TechDenNL/GameConsole/Docs/Game-Console v3.31/5 - Game-Console panel v3.3 - solder.jpg

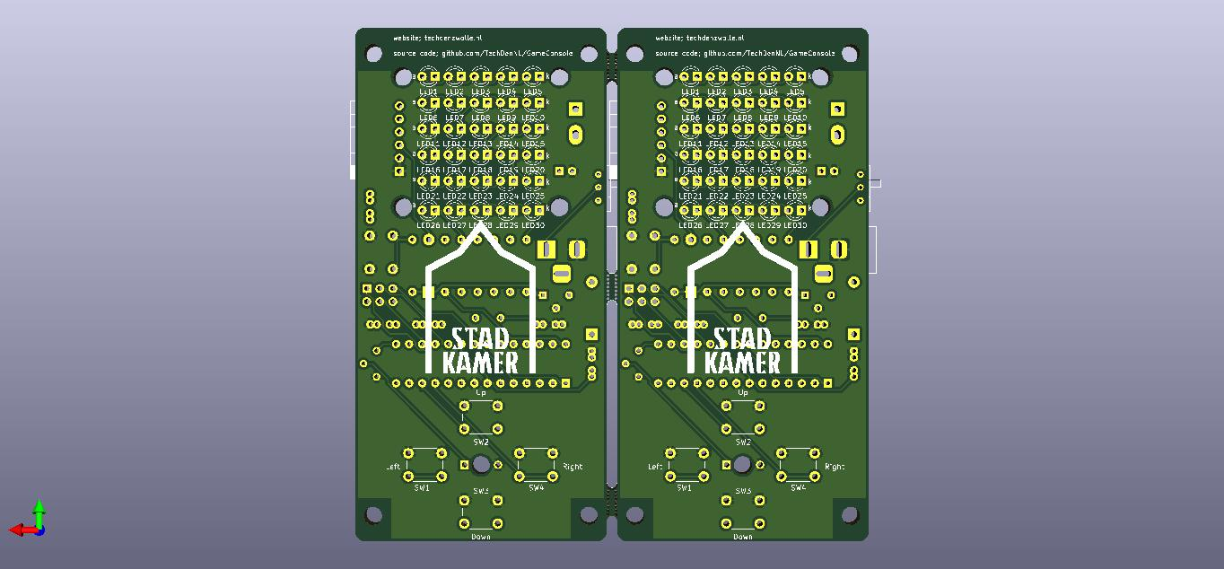
Docs/Game-Console v3.31/5 - Game-Console panel v3.3 - solder.jpg
