TechDenNL/GameConsole/Docs/GameConsole v3.1/pcb-design.jpeg

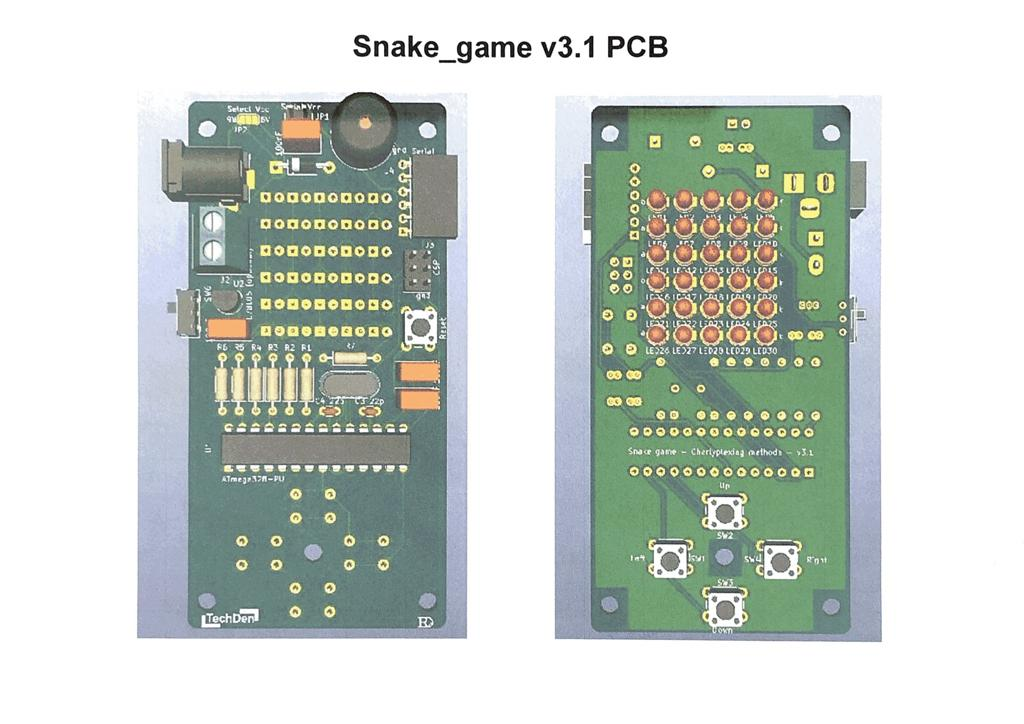
Docs/GameConsole v3.1/pcb-design.jpeg
