TechDenNL/GameConsole/Docs/GameConsole v3.1/Snakegame HW presentatie.pptx

## Snakegame

with 30 LEDs Charlyplexing methode

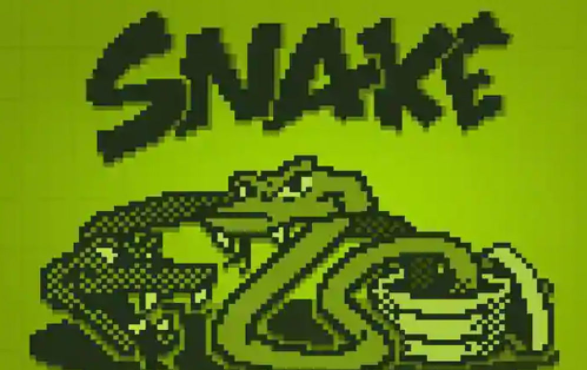
[picture p3: figure]
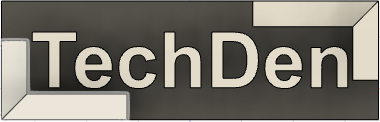
[picture p4: figure]

## Interne snakegame workshops

Ma 5 juli; Uitleg HW & solderen -> Roland
Ma 19 juli; Uitleg SW principe
& Arduino IDE -> Jacko
Ma 2 aug; Zelf applicatie maken &
Nadenken hoe externe workshops

Notes: Uitleg schema

## Snakegame HW

- Items:
1. Bare Arduino
2. Leds control; Charlyplexing
3. Buttons & Piezo speaker
4. Programming interfaces
  - ICSP; in-circuit serial programming Used for programming bootloader
  - Serial ; Needs a FTDI USB->TTL board Used for uploading sketches
5. Power Supply
6. PCB

Notes: Uitleg schema

## Bare Arduino

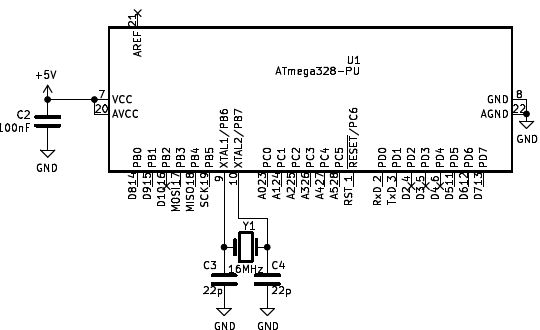
[picture p5: figure]
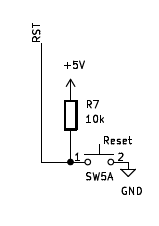
[picture p6: figure]

## Multiplexed LED matrix

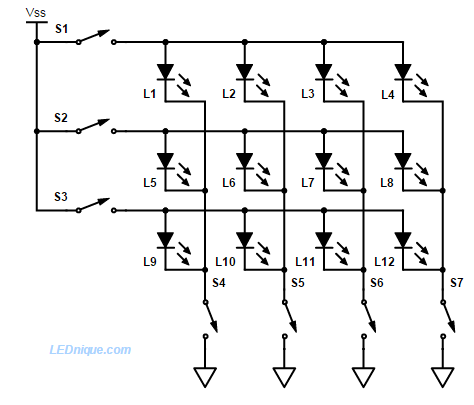
[picture p7: figure]

## Charlyplexed LED matrix

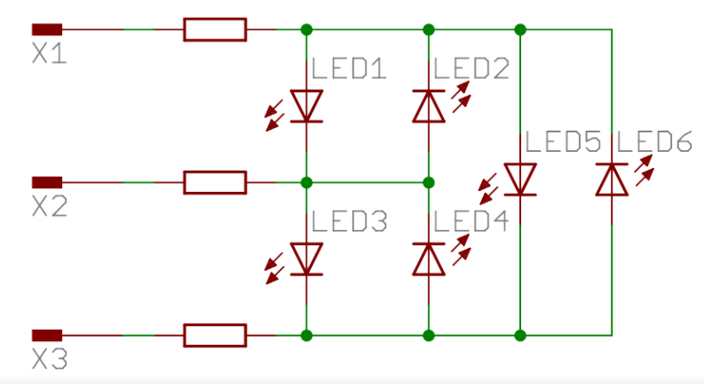
[picture p8: figure]

See; Charlyplexing LED matrix (https://www.keychainino.com/how-to-drive-many-leds-with-only-few-pins-charlieplexing/)
#Leds = N*(N-1)

## Charlyplexed LED matrix

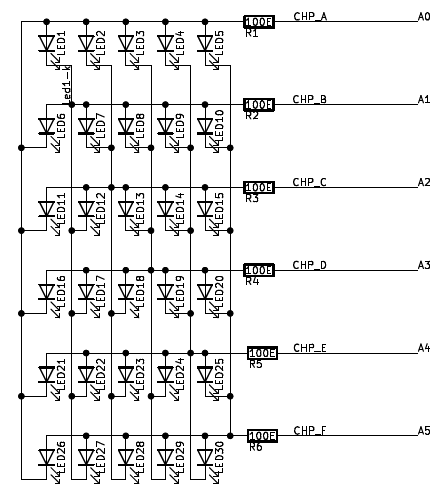
[picture p9: figure]

## Buttons & Piezo speaker

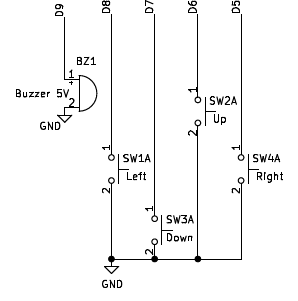
[picture p10: figure]

## Programming Interfaces

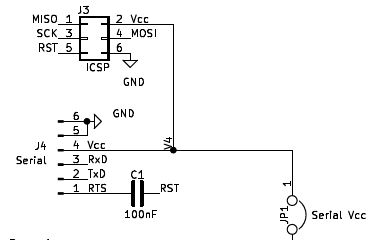
[picture p11: figure]

## External FTDI Board

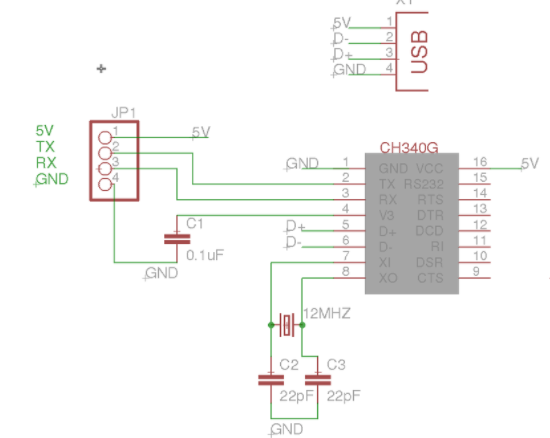
[picture p12: figure]

## Power supply

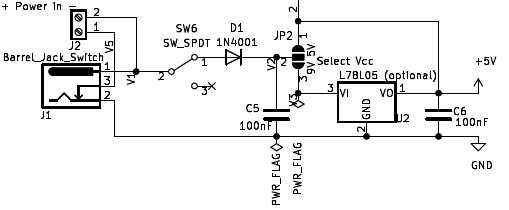
[picture p13: figure]

## PCB

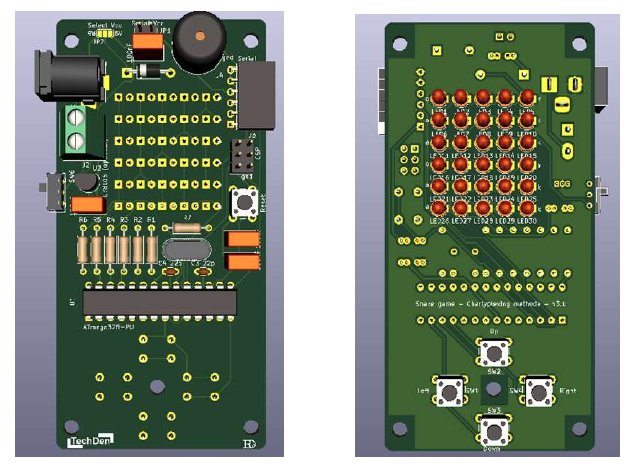
[picture p14: figure]

## Case voorbeeld

- Demo (https://photos.google.com/photo/AF1QipMvibJTCEs83evP2M-1D9h0I7eIBJrP884PtY1R?hl=nl)

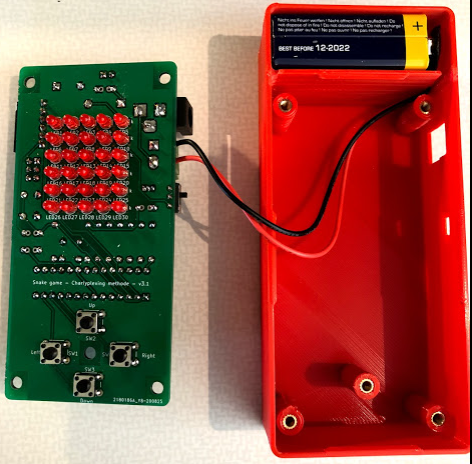
[picture p15: figure]
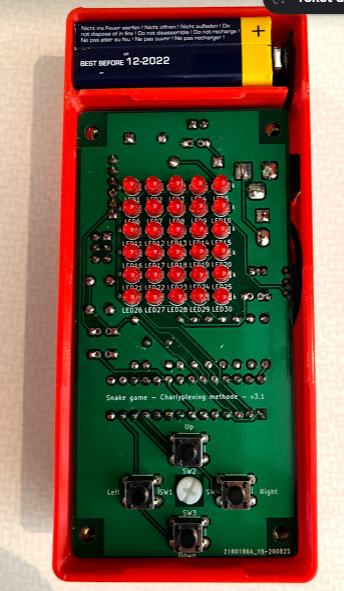
[picture p16: figure]
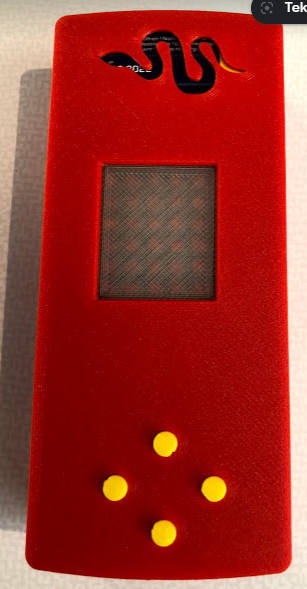
[picture p17: figure]

## Check

- LEDs & 4 Buttons op achterzijde van PCB!!
- Polariteit leds & diode
- Positie ATMEGA328
- Jumpers Power supply
- Positie FTDI boardje
ATMEGA328 is reeds voorzien van bootloader & DEMO sketch
