TechDenNL/GameConsole/Docs/Game-Console v3.31/10 - Programmer board.pdf

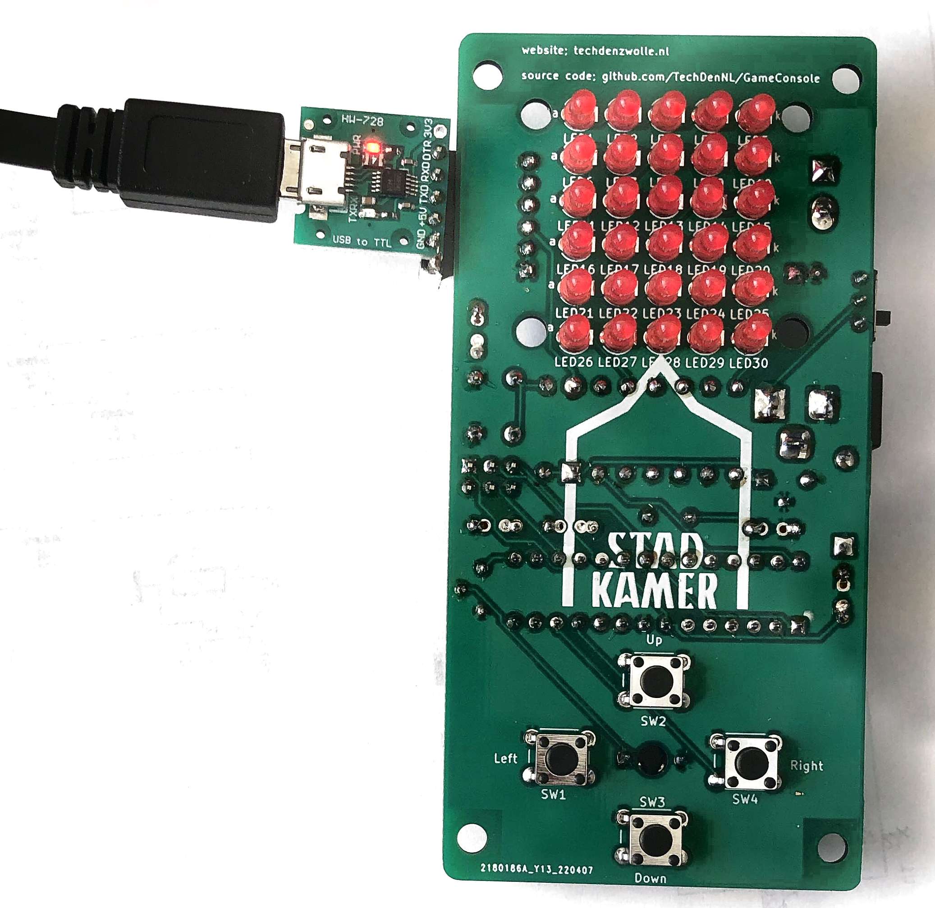
[picture p20: page 1]
