TechDenNL/GameConsole/Docs/Game-Console v3.31/2 - Game-Console v3.3 - comp.jpg

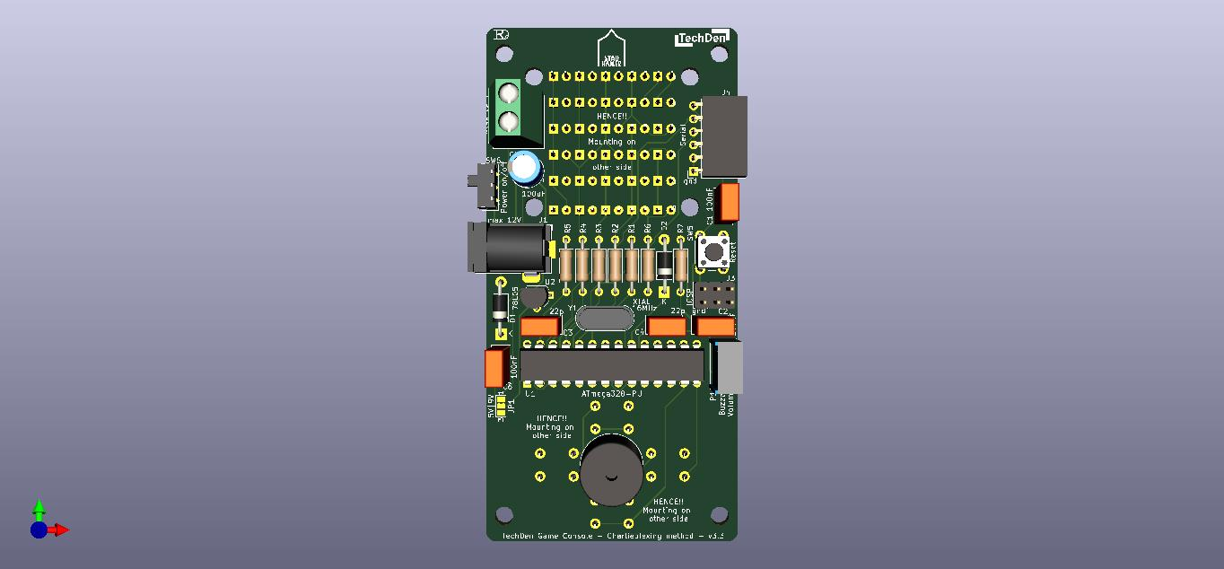
Docs/Game-Console v3.31/2 - Game-Console v3.3 - comp.jpg
