TechDenNL/GameConsole/Docs/Game-Console v3.31/4 - Game-Console panel v3.3 - comp.jpg

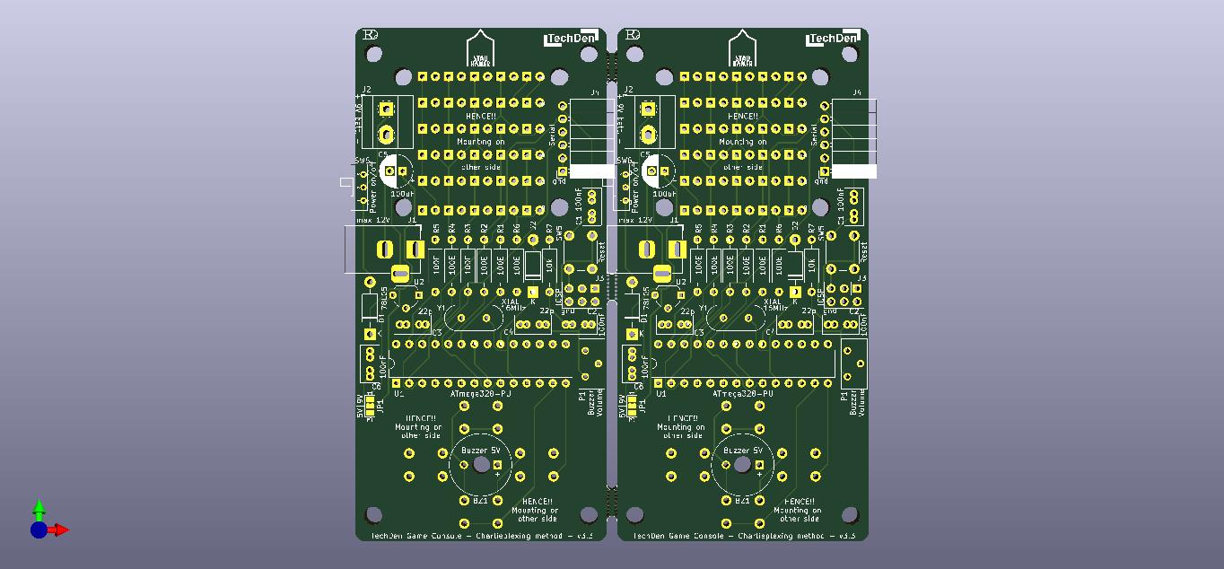
Docs/Game-Console v3.31/4 - Game-Console panel v3.3 - comp.jpg
