TechDenNL/GameConsole/Docs/Game-Console v3.31/6 - GameConsole v3.3 Enclosure.jpg

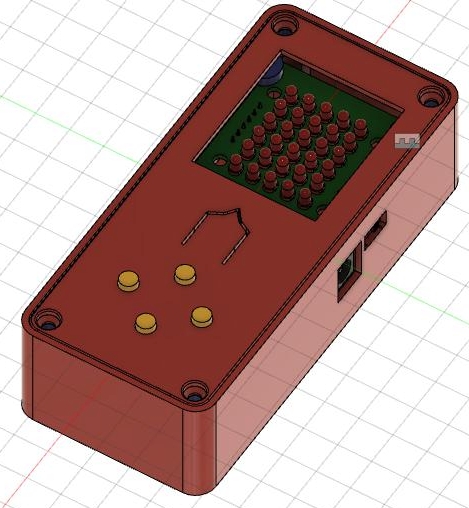
Docs/Game-Console v3.31/6 - GameConsole v3.3 Enclosure.jpg
