TechDenNL/GameConsole/Docs/Game-Console v3.31/Enclosure/GameConsole Fusion360.JPG

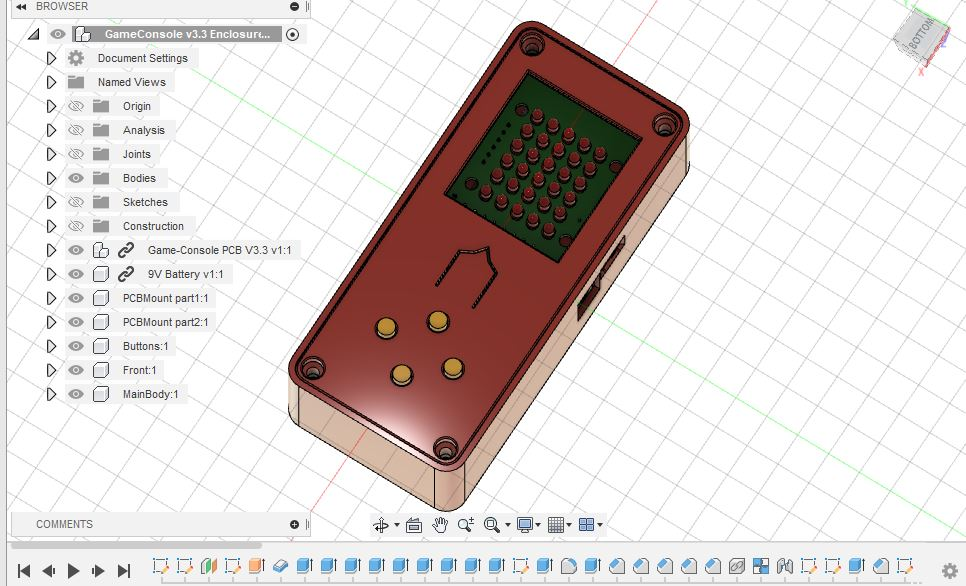
Docs/Game-Console v3.31/Enclosure/GameConsole Fusion360.JPG
