TechDenNL/GameConsole/Docs/GameConsole v3.1/Electrical drawing.jpeg

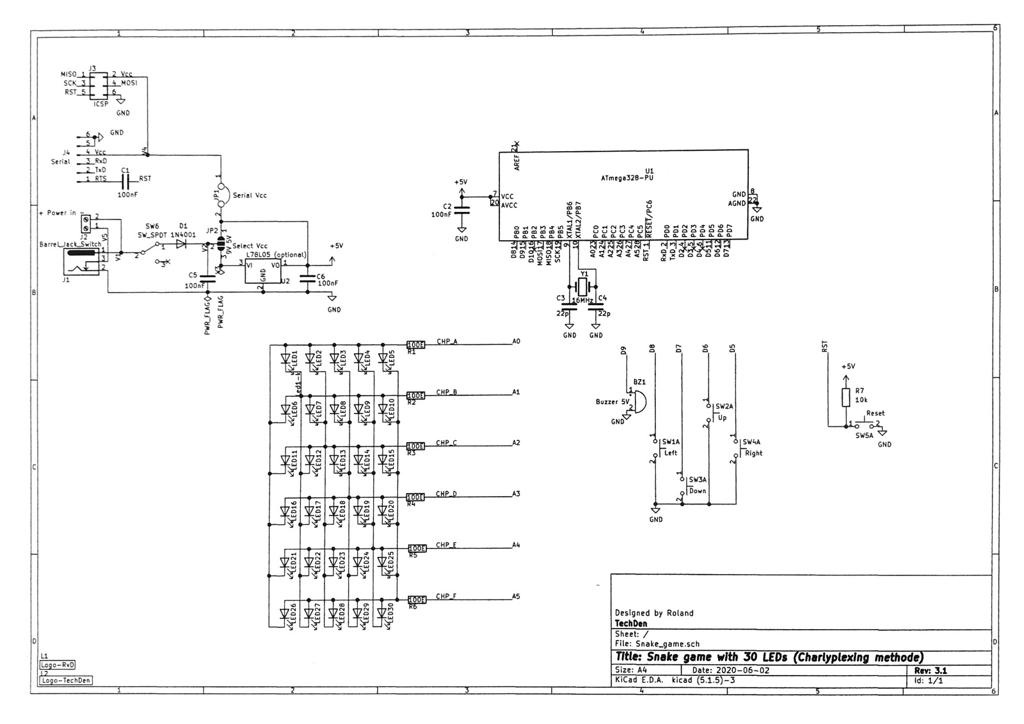
Docs/GameConsole v3.1/Electrical drawing.jpeg
