TechDenNL/GameConsole/Docs/Game-Console v3.31/8 - Game-Console v3.3 - BOM.xlsx

Componenten
Designator | Designation | Quantity
FTDI board | usb to TTL | 1
BZ1 | Buzzer 5V passive | 1
9V connector | met Jack connector | 1
C1,C2,C6 | 100nF | 3
C4,C3 | 22p | 2
C5 | 100uF - 25V | 1
D2,D1 | 1N4007 | 2
J1 | Barrel_Jack_Switch | 1
J3 | ICSP conn | 0.1
J2 | Terminalblock 2p | 1
J4 | Serial conn | 0.2
LED1-LED30 | LED Red Ultra bright | 30
P1 | trimmer 1k | 1
R1-R6 | 100E | 6
R7 | 10k | 1
SW1-SW5 | push button | 5
SW6 | on/off switch | 1
U1 | Socket dip28 | 1
U2 | 78L05 | 1
Y1 | 16MHz | 1
