TechDenNL/GameConsole/Docs/GameConsole v3.1/Snake_game_bom_3.1.xlsx

Sheet: Snake_game_bom_3.1 Costs
# | Quantity | Part | References | Value | Description | Price/part | Costs
1 | 1 | PCB | Snake game | v3.1 | PCB | €2.50 | €2.50
2 | 1 | Buzzer | BZ1 | Buzzer 5V | Buzzer, polarized | €0.20 | €0.20
3 | 4 | C | C1 C2 C5 C6 | 100nF | Unpolarized capacitor | €0.02 | €0.08
4 | 2 | C | C3 C4 | 22p | Unpolarized capacitor | €0.05 | €0.10
5 | 1 | 1N4007 | D1 | 1N4007 | 1kV 1A General Purpose Rectifier Diode, DO-41 | €0.02 | €0.02
6 | 1 | Barrel_Jack | J1 | Barrel_Jack (optional) | DC Barrel Jack with an internal switch | €0.10 | €0.10
7 | 1 | Screw_Terminal_01x02 | J2 | + Power in - (optional) | Generic screw terminal, single row, 01x02 | €0.15 | €0.15
8 | 1 | Conn_02x03_Male | J3 | ICSP | Generic connector, double row, 02x03, male | €0.02 | €0.02
9 | 1 | Conn_01x06_Female | J4 | Serial | Generic connector, single row, 01x06, female | €0.02 | €0.02
10 | 1 | Jumperpins & jumper | JP1 | Serial Vcc | Jumperpins & jumper | €0.02 | €0.02
11 | 30 | LED | LED1 - LED30 | LED Red | Light emitting diode | €0.05 | €1.50
12 | 6 | R | R1 R2 R3 R4 R5 R6 | 100E | Resistor | €0.02 | €0.12
13 | 1 | R | R7 | 10k | Resistor | €0.02 | €0.02
14 | 5 | SW_Push_Dual | SW1 | Push button | Push button switch | €0.02 | €0.10
15 | 1 | SW_SPDT | SW6 | SW_SPDT (optional) | Switch, single pole double throw | €0.10 | €0.10
16 | 1 | ATmega328-PU | U1 | ATmega328-PU | 20MHz, 32kB Flash, 2kB SRAM, 1kB EEPROM, DIP-28 | €1.50 | €1.50
17 | 1 | Socket | U1 | 28p | Socket 28p | €0.20 | €0.20
17 | 1 | 78L05 | U2 | L78L05 (optional) | Positive 100mA 30V Linear Regulator, Output 5V, TO-92 | €0.05 | €0.05
18 | 1 | Crystal | Y1 | 16MHz | Two pin crystal | €0.10 | €0.10
18 | 1 | 9V batterij connector |  | Batterij conn (optional) | Batterij conn (optional) |  | €0.00 | €0.35 | €0.35
19 | 1 | FTDI board |  | FTDI (optional) | USB to TTL converter board (optional) | €0.60 | €0.60
 |  |  |  |  |  | Total | €7.50
 |  | Schematic: | Snake game
 |  | Schematic Version: | 3.1
 |  | Schematic Date: | 2020-06-02

Sheet: Snake_game_bom_3.1
# | Quantity | Part | References | Value | Description | Footprint | Datasheet
1 | 1 | Buzzer | BZ1 | Buzzer 5V | Buzzer, polarized | Buzzer_12x9.5RM7.6 | ~
2 | 4 | C | C1 C2 C5 C6 | 100nF | Unpolarized capacitor | C_Rect_L7.0mm_W3.5mm_P2.50mm_P5.00mm | ~
3 | 2 | C | C3 C4 | 22p | Unpolarized capacitor | C_Disc_D3.0mm_W1.6mm_P2.50mm | ~
4 | 1 | 1N4001 | D1 | 1N4001 | 50V 1A General Purpose Rectifier Diode, DO-41 | D_DO-41_SOD81_P10.16mm_Horizontal | http://www.vishay.com/docs/88503/1n4001.pdf
5 | 1 | Screw_Terminal_01x02 | J2 | + Power in - | Generic screw terminal, single row, 01x02, script generated (kicad-library-utils/schlib/autogen/connector/) | TerminalBlock_Phoenix_MKDS-1,5-2-5.08_1x02_P5.00&P5.08mm_Horizontal | ~
6 | 1 | Barrel_Jack_Switch | J1 | Barrel_Jack_Switch | DC Barrel Jack with an internal switch | BarrelJack_Horizontal | ~
7 | 1 | Conn_02x03_Odd_Even | J3 | ICSP | Generic connector, double row, 02x03, odd/even pin numbering scheme (row 1 odd numbers, row 2 even numbers), script generated (kicad-library-utils/schlib/autogen/connector/) | PinHeader_2x03_P2.54mm_Vertical | ~
8 | 1 | Conn_01x06_Male | J4 | Serial | Generic connector, single row, 01x06, script generated (kicad-library-utils/schlib/autogen/connector/) | PinSocket_1x06_P2.54mm_Horizontal | ~
9 | 1 | SolderJumper_3_Open | JP2 | Select Vcc | Solder Jumper, 3-pole, open | SolderJumper-3_P1.3mm_Open_RoundedPad1.0x1.5mm_NumberLabels | ~
10 | 1 | Jumper | JP1 | Serial Vcc | Jumper, normally closed | PinHeader_1x02_P2.54mm_Vertical | ~
11 | 1 | Logo-RvD-Logo | L1 | Logo-RvD |  | RvD Logo inverted small
12 | 1 | Logo-TechDen-Logo | L2 | Logo-TechDen |  | TechDen Logo - inverted
13 | 30 | LED | LED1 LED2 LED3 LED4 LED5 LED6 LED7 LED8 LED9 LED10 LED11 LED12 LED13 LED14 LED15 LED16 LED17 LED18 LED19 LED20 LED21 LED22 LED23 LED24 LED25 LED26 LED27 LED28 LED29 LED30 | LED | Light emitting diode | LED_D3.0mm | ~
14 | 6 | R | R1 R2 R3 R4 R5 R6 | 100E | Resistor | R_Axial_DIN0207_L6.3mm_D2.5mm_P10.16mm_Horizontal | ~
15 | 1 | R | R7 | 10k | Resistor | R_Axial_DIN0207_L6.3mm_D2.5mm_P10.16mm_Horizontal | ~
16 | 1 | SW_Push_Dual_x2 | SW3 | Down | Push button switch, generic, separate symbols, four pins | SW_PUSH_6mm
17 | 1 | SW_Push_Dual_x2 | SW1 | Left | Push button switch, generic, separate symbols, four pins | SW_PUSH_6mm
18 | 1 | SW_Push_Dual_x2 | SW5 | Reset | Push button switch, generic, separate symbols, four pins | SW_PUSH_6mm
19 | 1 | SW_Push_Dual_x2 | SW4 | Right | Push button switch, generic, separate symbols, four pins | SW_PUSH_6mm
20 | 1 | SW_SPDT | SW6 | SW_SPDT | Switch, single pole double throw | switch_MSK-12D19 | ~
21 | 1 | SW_Push_Dual_x2 | SW2 | Up | Push button switch, generic, separate symbols, four pins | SW_PUSH_6mm
22 | 1 | ATmega328-PU | U1 | ATmega328-PU | 20MHz, 32kB Flash, 2kB SRAM, 1kB EEPROM, DIP-28 | DIP-28_W7.62mm | http://ww1.microchip.com/downloads/en/DeviceDoc/ATmega328_P%20AVR%20MCU%20with%20picoPower%20Technology%20Data%20Sheet%2040001984A.pdf
23 | 1 | L78L05_TO92 | U2 | L78L05 (optional) | Positive 100mA 30V Linear Regulator, Fixed Output 5V, TO-92 | TO-92_Inline | http://www.st.com/content/ccc/resource/technical/document/datasheet/15/55/e5/aa/23/5b/43/fd/CD00000446.pdf/files/CD00000446.pdf/jcr:content/translations/en.CD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
24 | 1 | Crystal | Y1 | 16MHz | Two pin crystal | Crystal_HC49-4H_Vertical | ~
Component Groups: |  |  |  |  | 24
Component Count: |  |  |  |  | 62
Fitted Components: |  |  |  |  | 62
Number of PCBs: |  |  |  |  | 1
Total components: |  |  |  |  | 62
Schematic Version: |  |  |  |  | 3.1
Schematic Date: |  |  |  |  | 2020-06-02
PCB Variant: |  |  |  |  | [u'default']
BoM Date: |  |  |  |  | 2020-09-21 18:24
Schematic Source: |  |  |  |  | C:\Users\Roland enof Anita\Dropbox\MyKiCad\MySchematics\Snake_game\v3.1\Snake_game.sch
KiCad Version: |  |  |  |  | Eeschema (5.1.5)-3
