TechDenNL/GameConsole/Docs/GameConsole v3.1/Charlieplexingmatrix v3.1.xlsx

Sheet: Matrix (1)
 | PIN_CONFIG |  |  |  |  |  |  | PIN_STATE |  |  |  |  |  |  |  |  | Colomn labels
i1 | CHP_A | CHP_B | CHP_C | CHP_D | CHP_E | CHP_F | i2 | CHP_A | CHP_B | CHP_C | CHP_D | CHP_E | CHP_F | i3 | i4 | LEDnr | + pin | - pin
{{ | OUTPUT, | OUTPUT, | INPUT, | INPUT, | INPUT, | INPUT, | },{ | HIGH, | LOW, | LOW, | LOW, | LOW, | LOW, | }}, | // | 01 | CHP_A | CHP_B
{{ | OUTPUT, | INPUT, | OUTPUT, | INPUT, | INPUT, | INPUT, | },{ | HIGH, | LOW, | LOW, | LOW, | LOW, | LOW, | }}, | // | 02 | CHP_A | CHP_C
{{ | OUTPUT, | INPUT, | INPUT, | OUTPUT, | INPUT, | INPUT, | },{ | HIGH, | LOW, | LOW, | LOW, | LOW, | LOW, | }}, | // | 03 | CHP_A | CHP_D
{{ | OUTPUT, | INPUT, | INPUT, | INPUT, | OUTPUT, | INPUT, | },{ | HIGH, | LOW, | LOW, | LOW, | LOW, | LOW, | }}, | // | 04 | CHP_A | CHP_E
{{ | OUTPUT, | INPUT, | INPUT, | INPUT, | INPUT, | OUTPUT, | },{ | HIGH, | LOW, | LOW, | LOW, | LOW, | LOW, | }}, | // | 05 | CHP_A | CHP_F
{{ | OUTPUT, | OUTPUT, | INPUT, | INPUT, | INPUT, | INPUT, | },{ | LOW, | HIGH, | LOW, | LOW, | LOW, | LOW, | }}, | // | 06 | CHP_B | CHP_A
{{ | INPUT, | OUTPUT, | OUTPUT, | INPUT, | INPUT, | INPUT, | },{ | LOW, | HIGH, | LOW, | LOW, | LOW, | LOW, | }}, | // | 07 | CHP_B | CHP_C
{{ | INPUT, | OUTPUT, | INPUT, | OUTPUT, | INPUT, | INPUT, | },{ | LOW, | HIGH, | LOW, | LOW, | LOW, | LOW, | }}, | // | 08 | CHP_B | CHP_D
{{ | INPUT, | OUTPUT, | INPUT, | INPUT, | OUTPUT, | INPUT, | },{ | LOW, | HIGH, | LOW, | LOW, | LOW, | LOW, | }}, | // | 09 | CHP_B | CHP_E
{{ | INPUT, | OUTPUT, | INPUT, | INPUT, | INPUT, | OUTPUT, | },{ | LOW, | HIGH, | LOW, | LOW, | LOW, | LOW, | }}, | // | 10 | CHP_B | CHP_F
{{ | OUTPUT, | INPUT, | OUTPUT, | INPUT, | INPUT, | INPUT, | },{ | LOW, | LOW, | HIGH, | LOW, | LOW, | LOW, | }}, | // | 11 | CHP_C | CHP_A
{{ | INPUT, | OUTPUT, | OUTPUT, | INPUT, | INPUT, | INPUT, | },{ | LOW, | LOW, | HIGH, | LOW, | LOW, | LOW, | }}, | // | 12 | CHP_C | CHP_B
{{ | INPUT, | INPUT, | OUTPUT, | OUTPUT, | INPUT, | INPUT, | },{ | LOW, | LOW, | HIGH, | LOW, | LOW, | LOW, | }}, | // | 13 | CHP_C | CHP_D
{{ | INPUT, | INPUT, | OUTPUT, | INPUT, | OUTPUT, | INPUT, | },{ | LOW, | LOW, | HIGH, | LOW, | LOW, | LOW, | }}, | // | 14 | CHP_C | CHP_E
{{ | INPUT, | INPUT, | OUTPUT, | INPUT, | INPUT, | OUTPUT, | },{ | LOW, | LOW, | HIGH, | LOW, | LOW, | LOW, | }}, | // | 15 | CHP_C | CHP_F
{{ | OUTPUT, | INPUT, | INPUT, | OUTPUT, | INPUT, | INPUT, | },{ | LOW, | LOW, | LOW, | HIGH, | LOW, | LOW, | }}, | // | 16 | CHP_D | CHP_A
{{ | INPUT, | OUTPUT, | INPUT, | OUTPUT, | INPUT, | INPUT, | },{ | LOW, | LOW, | LOW, | HIGH, | LOW, | LOW, | }}, | // | 17 | CHP_D | CHP_B
{{ | INPUT, | INPUT, | OUTPUT, | OUTPUT, | INPUT, | INPUT, | },{ | LOW, | LOW, | LOW, | HIGH, | LOW, | LOW, | }}, | // | 18 | CHP_D | CHP_C
{{ | INPUT, | INPUT, | INPUT, | OUTPUT, | OUTPUT, | INPUT, | },{ | LOW, | LOW, | LOW, | HIGH, | LOW, | LOW, | }}, | // | 19 | CHP_D | CHP_E
{{ | INPUT, | INPUT, | INPUT, | OUTPUT, | INPUT, | OUTPUT, | },{ | LOW, | LOW, | LOW, | HIGH, | LOW, | LOW, | }}, | // | 20 | CHP_D | CHP_F
{{ | OUTPUT, | INPUT, | INPUT, | INPUT, | OUTPUT, | INPUT, | },{ | LOW, | LOW, | LOW, | LOW, | HIGH, | LOW, | }}, | // | 21 | CHP_E | CHP_A
{{ | INPUT, | OUTPUT, | INPUT, | INPUT, | OUTPUT, | INPUT, | },{ | LOW, | LOW, | LOW, | LOW, | HIGH, | LOW, | }}, | // | 22 | CHP_E | CHP_B
{{ | INPUT, | INPUT, | OUTPUT, | INPUT, | OUTPUT, | INPUT, | },{ | LOW, | LOW, | LOW, | LOW, | HIGH, | LOW, | }}, | // | 23 | CHP_E | CHP_C
{{ | INPUT, | INPUT, | INPUT, | OUTPUT, | OUTPUT, | INPUT, | },{ | LOW, | LOW, | LOW, | LOW, | HIGH, | LOW, | }}, | // | 24 | CHP_E | CHP_D
{{ | INPUT, | INPUT, | INPUT, | INPUT, | OUTPUT, | OUTPUT, | },{ | LOW, | LOW, | LOW, | LOW, | HIGH, | LOW, | }}, | // | 25 | CHP_E | CHP_F
{{ | OUTPUT, | INPUT, | INPUT, | INPUT, | INPUT, | OUTPUT, | },{ | LOW, | LOW, | LOW, | LOW, | LOW, | HIGH, | }}, | // | 26 | CHP_F | CHP_A
{{ | INPUT, | OUTPUT, | INPUT, | INPUT, | INPUT, | OUTPUT, | },{ | LOW, | LOW, | LOW, | LOW, | LOW, | HIGH, | }}, | // | 27 | CHP_F | CHP_B
{{ | INPUT, | INPUT, | OUTPUT, | INPUT, | INPUT, | OUTPUT, | },{ | LOW, | LOW, | LOW, | LOW, | LOW, | HIGH, | }}, | // | 28 | CHP_F | CHP_C
{{ | INPUT, | INPUT, | INPUT, | OUTPUT, | INPUT, | OUTPUT, | },{ | LOW, | LOW, | LOW, | LOW, | LOW, | HIGH, | }}, | // | 29 | CHP_F | CHP_D
{{ | INPUT, | INPUT, | INPUT, | INPUT, | OUTPUT, | OUTPUT, | },{ | LOW, | LOW, | LOW, | LOW, | LOW, | HIGH | }} | // | 30 | CHP_F | CHP_E
CHP = Charleyplexing Pin

Sheet: Matrix (2)
// |  |  | PIN_CONFIG |  |  |  |  |  |  |  |  | PIN_STATE |  |  |  |  |  |  |  |  | Colomn labels
//i1 | x | x | CHP_A | CHP_B | CHP_C | CHP_D | CHP_E | CHP_F | i2 | x | x | CHP_A | CHP_B | CHP_C | CHP_D | CHP_E | CHP_F | i3 | i4 | LEDnr | + pin | - pin
{B | 0 | 0 | 1 | 1 | 0 | 0 | 0 | 0 | , B | 0 | 0 | 1 | 0 | 0 | 0 | 0 | 0 | }, | // | 01 | CHP_A | CHP_B
{B | 0 | 0 | 1 | 0 | 1 | 0 | 0 | 0 | , B | 0 | 0 | 1 | 0 | 0 | 0 | 0 | 0 | }, | // | 02 | CHP_A | CHP_C
{B | 0 | 0 | 1 | 0 | 0 | 1 | 0 | 0 | , B | 0 | 0 | 1 | 0 | 0 | 0 | 0 | 0 | }, | // | 03 | CHP_A | CHP_D
{B | 0 | 0 | 1 | 0 | 0 | 0 | 1 | 0 | , B | 0 | 0 | 1 | 0 | 0 | 0 | 0 | 0 | }, | // | 04 | CHP_A | CHP_E
{B | 0 | 0 | 1 | 0 | 0 | 0 | 0 | 1 | , B | 0 | 0 | 1 | 0 | 0 | 0 | 0 | 0 | }, | // | 05 | CHP_A | CHP_F
{B | 0 | 0 | 1 | 1 | 0 | 0 | 0 | 0 | , B | 0 | 0 | 0 | 1 | 0 | 0 | 0 | 0 | }, | // | 06 | CHP_B | CHP_A
{B | 0 | 0 | 0 | 1 | 1 | 0 | 0 | 0 | , B | 0 | 0 | 0 | 1 | 0 | 0 | 0 | 0 | }, | // | 07 | CHP_B | CHP_C
{B | 0 | 0 | 0 | 1 | 0 | 1 | 0 | 0 | , B | 0 | 0 | 0 | 1 | 0 | 0 | 0 | 0 | }, | // | 08 | CHP_B | CHP_D
{B | 0 | 0 | 0 | 1 | 0 | 0 | 1 | 0 | , B | 0 | 0 | 0 | 1 | 0 | 0 | 0 | 0 | }, | // | 09 | CHP_B | CHP_E
{B | 0 | 0 | 0 | 1 | 0 | 0 | 0 | 1 | , B | 0 | 0 | 0 | 1 | 0 | 0 | 0 | 0 | }, | // | 10 | CHP_B | CHP_F
{B | 0 | 0 | 1 | 0 | 1 | 0 | 0 | 0 | , B | 0 | 0 | 0 | 0 | 1 | 0 | 0 | 0 | }, | // | 11 | CHP_C | CHP_A
{B | 0 | 0 | 0 | 1 | 1 | 0 | 0 | 0 | , B | 0 | 0 | 0 | 0 | 1 | 0 | 0 | 0 | }, | // | 12 | CHP_C | CHP_B
{B | 0 | 0 | 0 | 0 | 1 | 1 | 0 | 0 | , B | 0 | 0 | 0 | 0 | 1 | 0 | 0 | 0 | }, | // | 13 | CHP_C | CHP_D
{B | 0 | 0 | 0 | 0 | 1 | 0 | 1 | 0 | , B | 0 | 0 | 0 | 0 | 1 | 0 | 0 | 0 | }, | // | 14 | CHP_C | CHP_E
{B | 0 | 0 | 0 | 0 | 1 | 0 | 0 | 1 | , B | 0 | 0 | 0 | 0 | 1 | 0 | 0 | 0 | }, | // | 15 | CHP_C | CHP_F
{B | 0 | 0 | 1 | 0 | 0 | 1 | 0 | 0 | , B | 0 | 0 | 0 | 0 | 0 | 1 | 0 | 0 | }, | // | 16 | CHP_D | CHP_A
{B | 0 | 0 | 0 | 1 | 0 | 1 | 0 | 0 | , B | 0 | 0 | 0 | 0 | 0 | 1 | 0 | 0 | }, | // | 17 | CHP_D | CHP_B
{B | 0 | 0 | 0 | 0 | 1 | 1 | 0 | 0 | , B | 0 | 0 | 0 | 0 | 0 | 1 | 0 | 0 | }, | // | 18 | CHP_D | CHP_C
{B | 0 | 0 | 0 | 0 | 0 | 1 | 1 | 0 | , B | 0 | 0 | 0 | 0 | 0 | 1 | 0 | 0 | }, | // | 19 | CHP_D | CHP_E
{B | 0 | 0 | 0 | 0 | 0 | 1 | 0 | 1 | , B | 0 | 0 | 0 | 0 | 0 | 1 | 0 | 0 | }, | // | 20 | CHP_D | CHP_F
{B | 0 | 0 | 1 | 0 | 0 | 0 | 1 | 0 | , B | 0 | 0 | 0 | 0 | 0 | 0 | 1 | 0 | }, | // | 21 | CHP_E | CHP_A
{B | 0 | 0 | 0 | 1 | 0 | 0 | 1 | 0 | , B | 0 | 0 | 0 | 0 | 0 | 0 | 1 | 0 | }, | // | 22 | CHP_E | CHP_B
{B | 0 | 0 | 0 | 0 | 1 | 0 | 1 | 0 | , B | 0 | 0 | 0 | 0 | 0 | 0 | 1 | 0 | }, | // | 23 | CHP_E | CHP_C
{B | 0 | 0 | 0 | 0 | 0 | 1 | 1 | 0 | , B | 0 | 0 | 0 | 0 | 0 | 0 | 1 | 0 | }, | // | 24 | CHP_E | CHP_D
{B | 0 | 0 | 0 | 0 | 0 | 0 | 1 | 1 | , B | 0 | 0 | 0 | 0 | 0 | 0 | 1 | 0 | }, | // | 25 | CHP_E | CHP_F
{B | 0 | 0 | 1 | 0 | 0 | 0 | 0 | 1 | , B | 0 | 0 | 0 | 0 | 0 | 0 | 0 | 1 | }, | // | 26 | CHP_F | CHP_A
{B | 0 | 0 | 0 | 1 | 0 | 0 | 0 | 1 | , B | 0 | 0 | 0 | 0 | 0 | 0 | 0 | 1 | }, | // | 27 | CHP_F | CHP_B
{B | 0 | 0 | 0 | 0 | 1 | 0 | 0 | 1 | , B | 0 | 0 | 0 | 0 | 0 | 0 | 0 | 1 | }, | // | 28 | CHP_F | CHP_C
{B | 0 | 0 | 0 | 0 | 0 | 1 | 0 | 1 | , B | 0 | 0 | 0 | 0 | 0 | 0 | 0 | 1 | }, | // | 29 | CHP_F | CHP_D
{B | 0 | 0 | 0 | 0 | 0 | 0 | 1 | 1 | , B | 0 | 0 | 0 | 0 | 0 | 0 | 0 | 1 | } | // | 30 | CHP_F | CHP_E
CHP = Charleyplexing Pin

Sheet: Layout
led1 | led2 | led3 | led4 | led5
led6 | led7 | led8 | led9 | led10
led11 | led12 | led13 | led14 | led15
led16 | led17 | led18 | led19 | led20
led21 | led22 | led23 | led24 | led25
led26 | led27 | led28 | led29 | led30
