TechDenNL/GameConsole/Docs/GameConsole v3.1/parts.jpeg

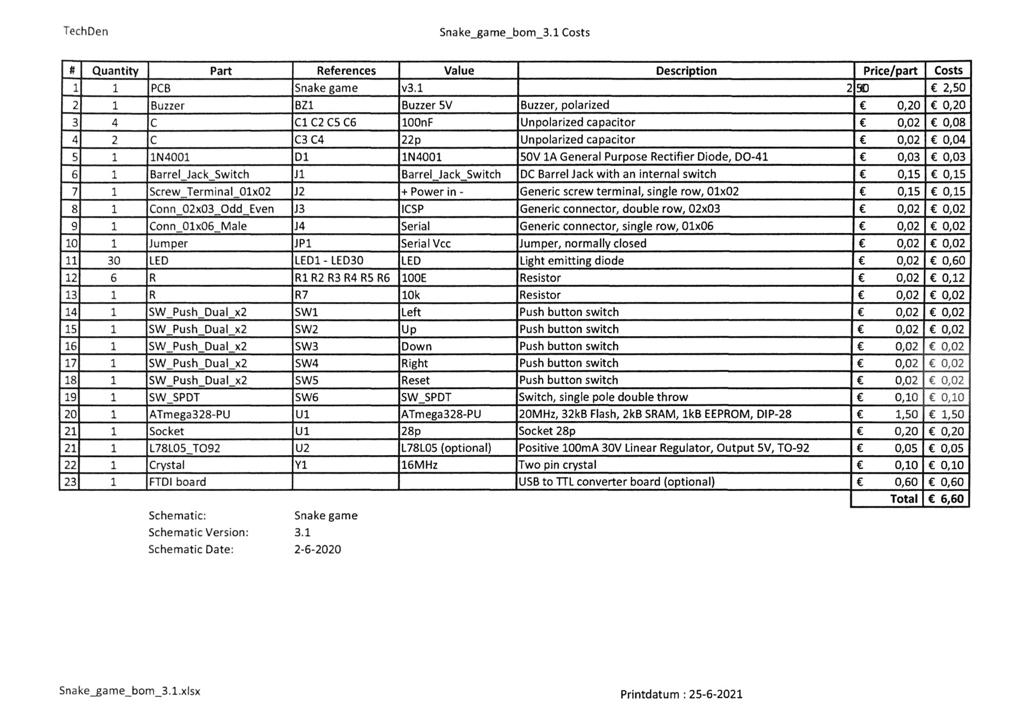
Docs/GameConsole v3.1/parts.jpeg
