TechDenNL/GameConsole/Docs/Game-Console v3.31/Enclosure/MainBody.stl

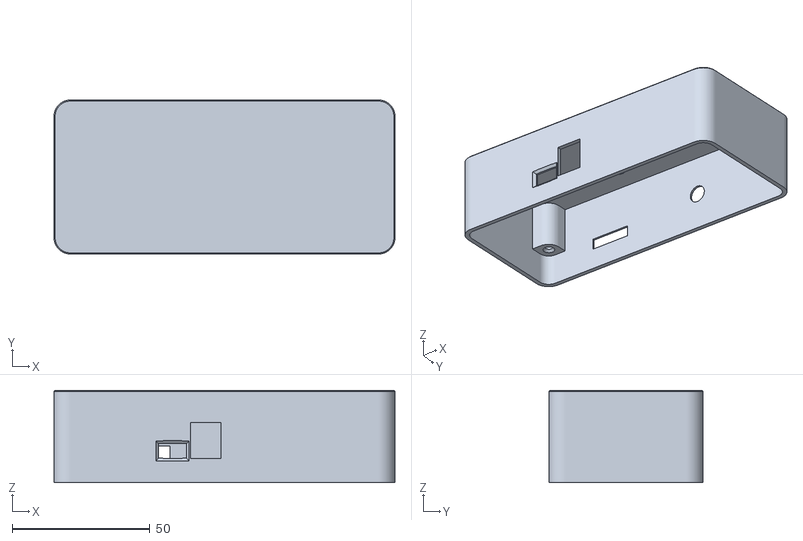
[picture p27: CAD file, 2022-07-28]
Docs/Game-Console v3.31/Enclosure/MainBody.stl
124.0 x 56.0 x 33.6
