TechDenNL/GameConsole/Docs/Game-Console v3.31/Enclosure/Overlay.stl

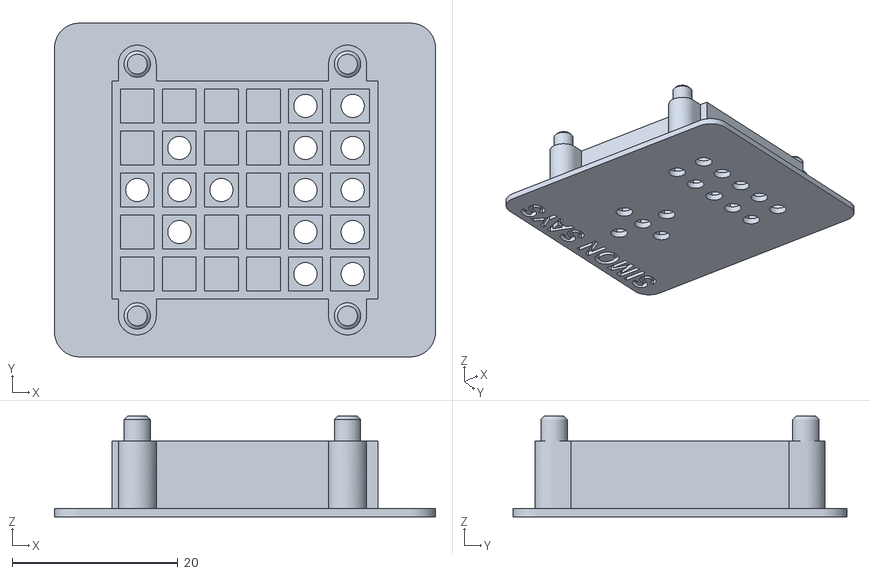
[picture p28: CAD file, 2022-07-28]
Docs/Game-Console v3.31/Enclosure/Overlay.stl
46.0 x 40.3 x 12.1
