TechDenNL/GameConsole/Docs/Game-Console v3.31/Enclosure/Buttons.stl

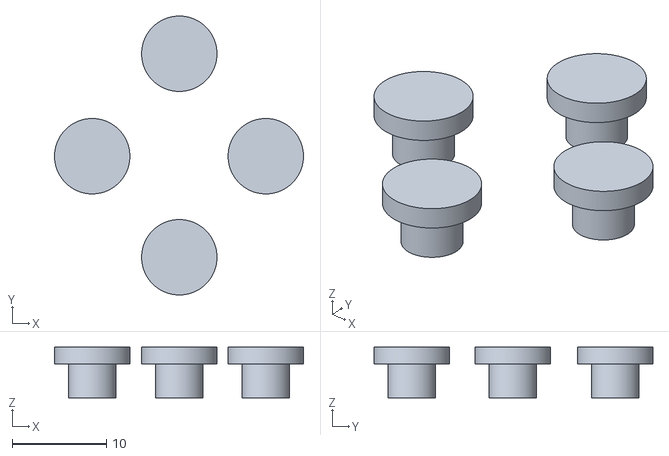
[picture p29: CAD file, 2022-07-28]
Docs/Game-Console v3.31/Enclosure/Buttons.stl
26.4 x 29.6 x 5.40
