TechDenNL/GameConsole/Docs/Game-Console v3.31/Enclosure/PCBMount part2.stl

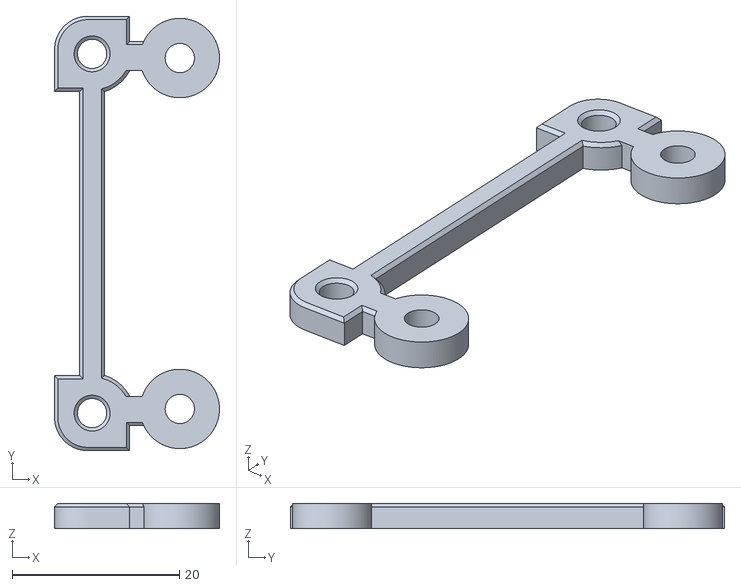
[picture p30: CAD file, 2022-07-28]
Docs/Game-Console v3.31/Enclosure/PCBMount part2.stl
19.7 x 52.0 x 3.00
