TechDenNL/GameConsole/Docs/Game-Console v3.31/Enclosure/Front.stl

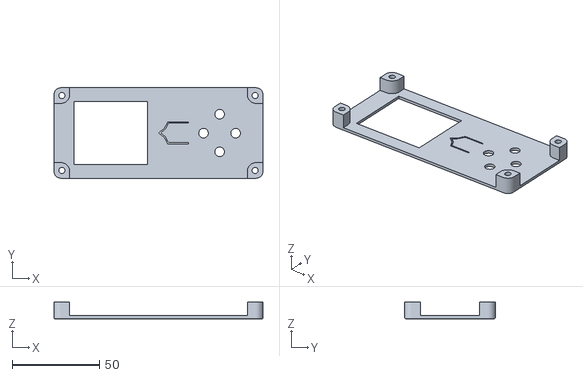
[picture p31: CAD file, 2022-07-28]
Docs/Game-Console v3.31/Enclosure/Front.stl
120.0 x 52.0 x 9.55
