TechDenNL/GameConsole/Docs/Game-Console v3.31/Enclosure/PCBMount part1.stl

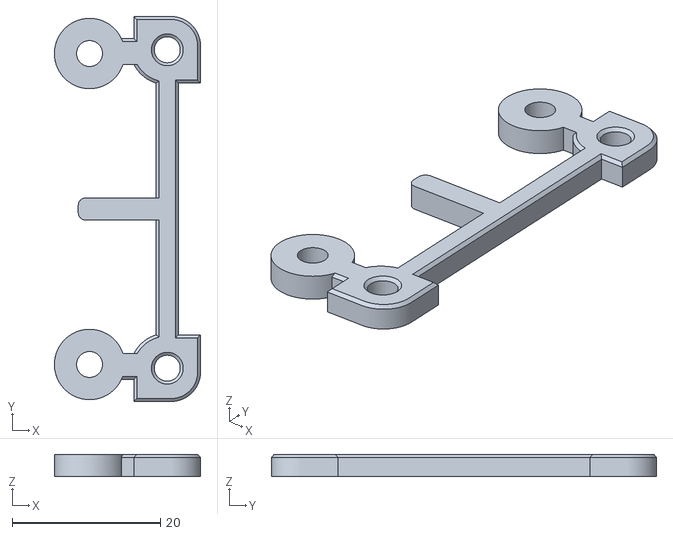
[picture p32: CAD file, 2022-07-28]
Docs/Game-Console v3.31/Enclosure/PCBMount part1.stl
19.7 x 52.0 x 3.00
