TechDenNL/GameConsole/Docs/Presentatie Workshop Solderen/TechDen Montage instructie v01.pptx

## TechDen Zwolle Workshop Solderen Montage instructie Game Console

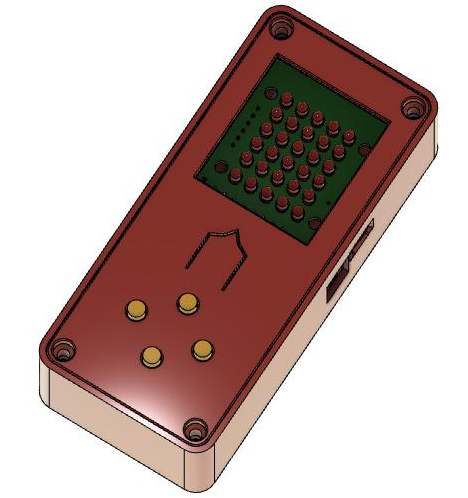
[picture p33: figure]

## 1- Leds & Buttons

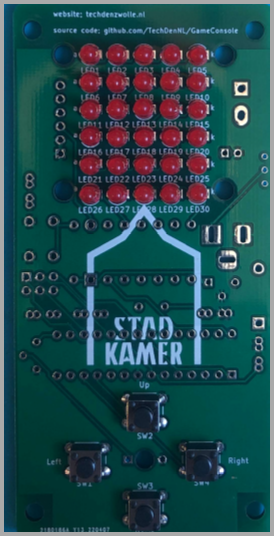
[picture p34: figure]

Voorzijde

## 2 - Weerstandjes + Diode

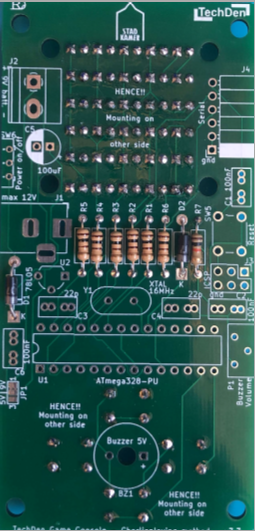
[picture p35: figure]

Achterzijde

## 3 - Chip voetje

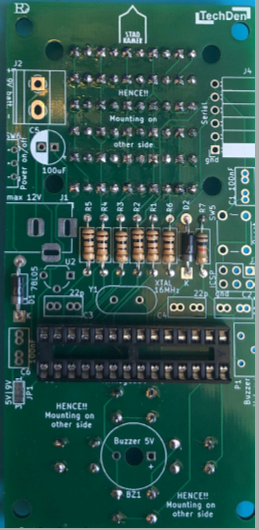
[picture p36: figure]

Achterzijde

## 4 – Programmeer connector

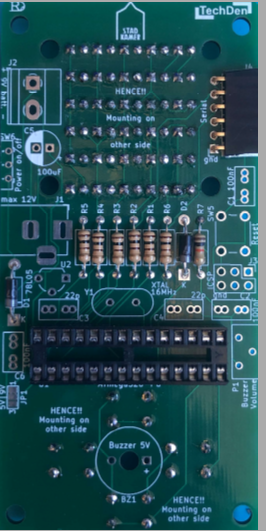
[picture p37: figure]

Achterzijde

## 5 – Condensatoren & Kristal

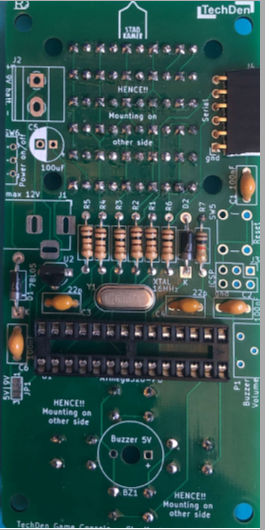
[picture p38: figure]

Achterzijde

## 6 – Druk- & schuifschakelaar

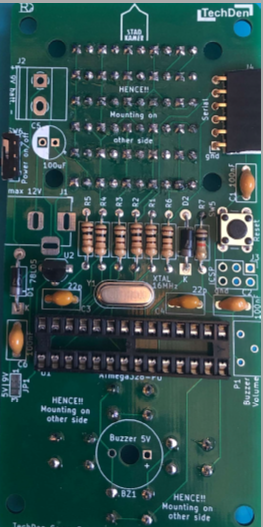
[picture p39: figure]

Achterzijde

## TechDen Zwolle

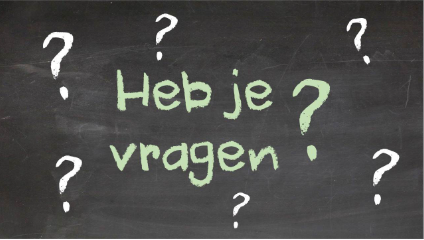
[picture p40: figure]

Notes: Uitleg schema
