TechDenNL/GameConsole/Docs/Game-Console v3.31/1 - Game-Console v3.31 - schematic.pdf

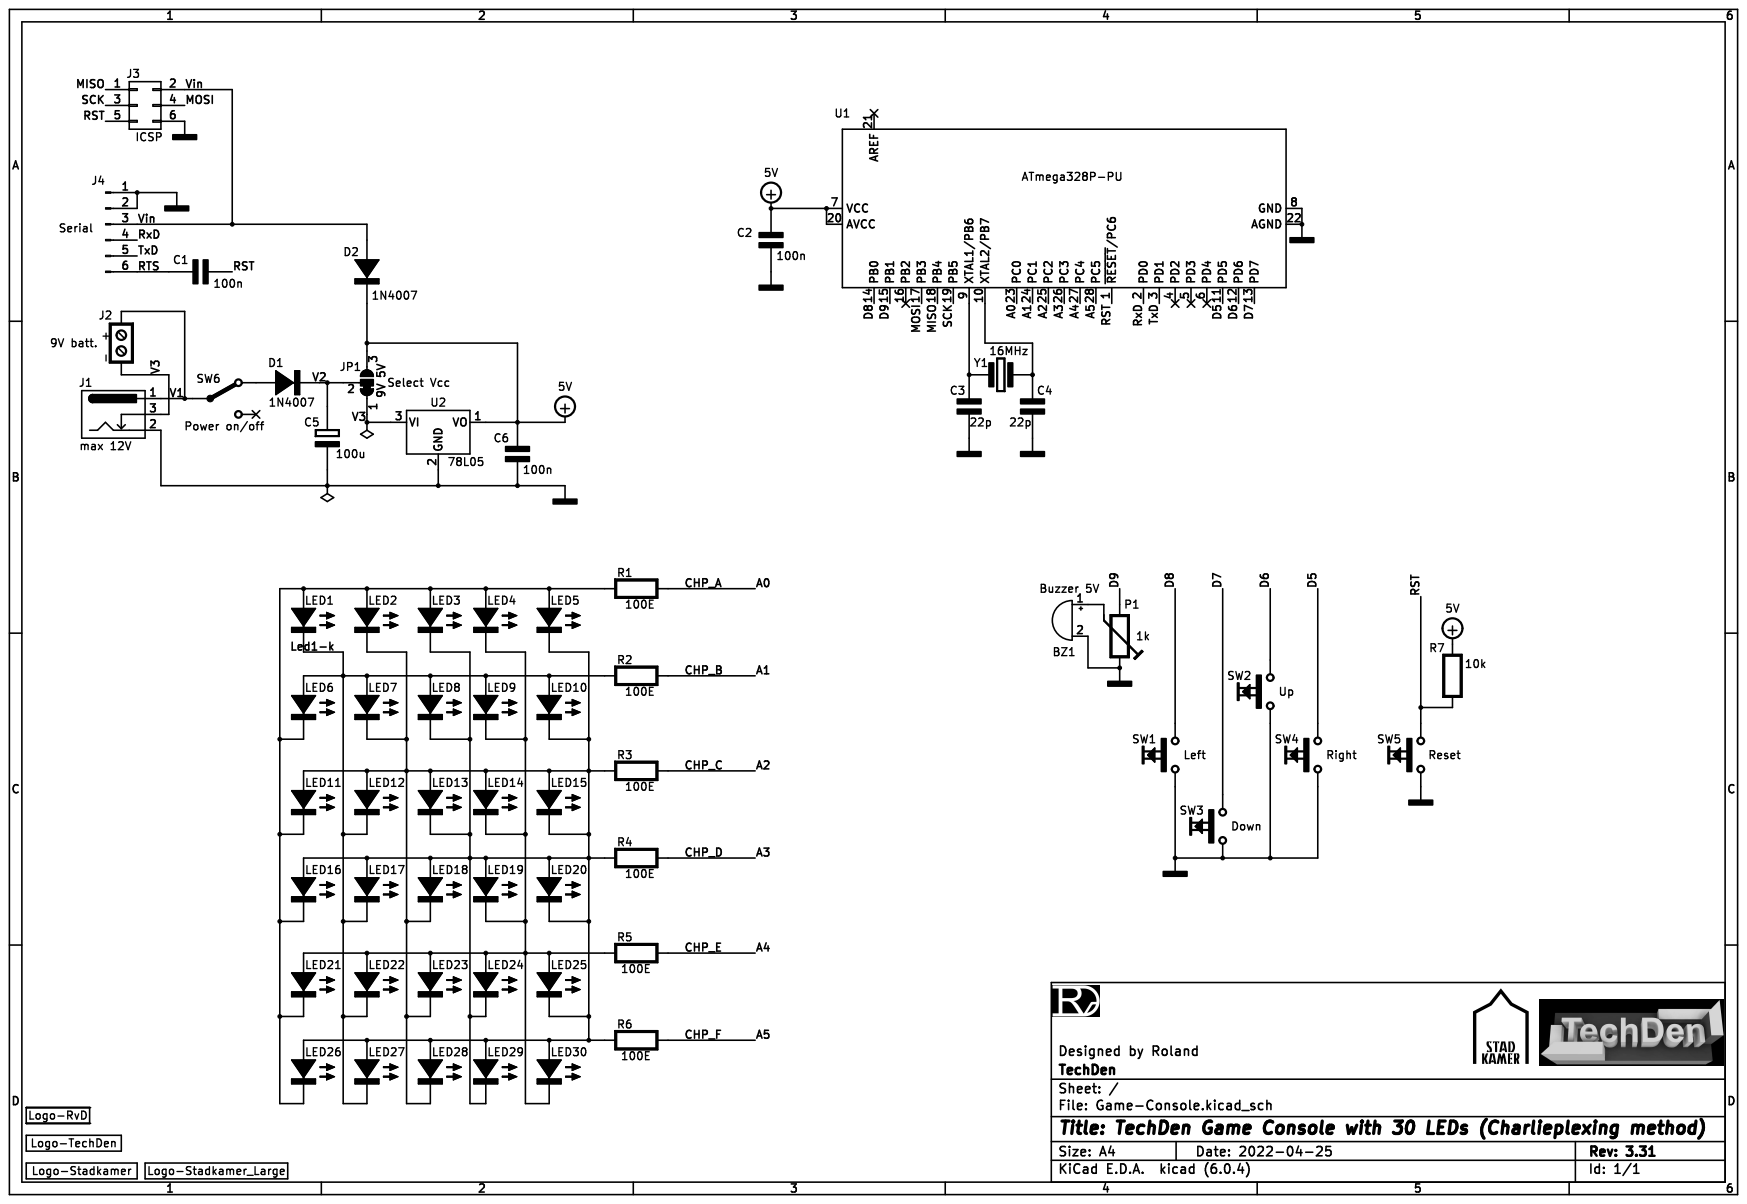
[picture p64: page 1]
