TechDenNL/GameConsole/code/Roland/GameConsole_Pong/Sprites.h

//sprites
uint8_t sad[] = {
B00000000,
B00001010,
B00000000,
B00001110,
B00010001,
B00000000,
};
 
uint8_t smile[] = {
B00000000,
B00001010,
B00000000,
B00010001,
B00001110,
B00000000,
};

uint8_t wink[] = {
B00000000,
B00001000,
B00000000,
B00010001,
B00001110,
B00000000,
};

uint8_t downArrow[] = {
B00000100,
B00000100,
B00000100,
B00010101,
B00001110,
B00000100,
};

uint8_t empty[] = {
B00000000,
B00000000,
B00000000,
B00000000,
B00000000,
B00000000,
};
