TechDenNL/GameConsole/(commit log)

2021-09-06 Initial files Roland
    [Charlieplexingmatrix v3.1.xlsx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]
2021-09-13 Refactor
    Removed obsolete files.
    Moved documentation files
    [Snake_game PCB v3.1.f3d, Snakegame Enclosure v3.1 v1.f3z]
2022-07-28 GameConsole v3.31
    KiCad files version 3.31 added
    Docs updates
    Presentations added
    [8 - Game-Console v3.3 - BOM.xlsx, Buttons.stl, Charlieplexingmatrix v3.1.xlsx, Front.stl, Game-Console.dsn, Game-Console.kicad_pcb, Game-Console.kicad_sch, Game-Console_3.31_BOM.xlsx]
2022-08-08 Update
    Update of my games
    Update prestation september
    KiCad6 ProjectArchive
    [Game-Console.dsn, Game-Console.kicad_pcb, Game-Console.kicad_sch, Game-Console_3.31_BOM.xlsx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]
